cdrfiuba/skil/doc/caratula.tex

{
  
\centering reemplazar esta pagina por la que está armada en LibreOffice

\begin{center}
  \begin{tabular}{p{0.8\linewidth} p{3cm}}
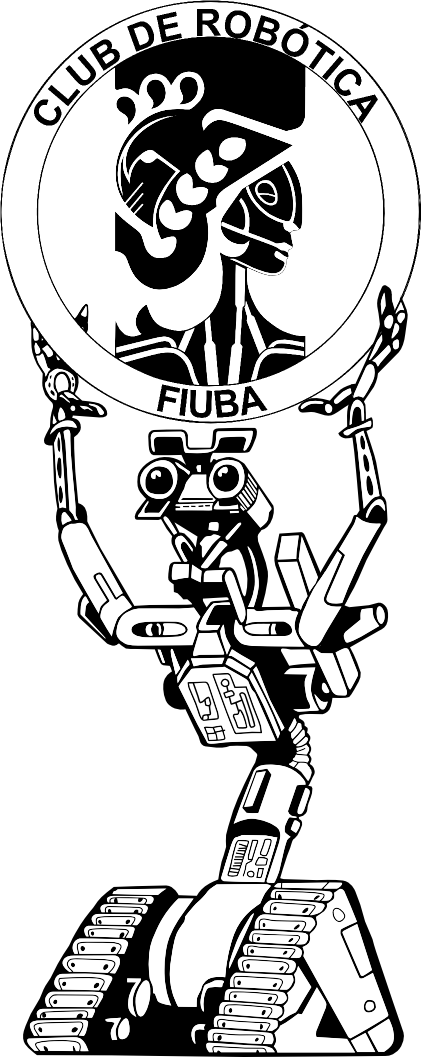
[picture p1: doc/img/logo_johnny5.png]
    \Huge Competencia de Robótica & \multirow{3}{*}{} \\
    {\Huge JOHNNY 5 }& \\
    $\sim$2015$\sim$&
  \end{tabular}
\end{center}
\large

\vspace{2cm}

Categoría: Minisumo

\vspace{.5cm}

Nombre del Robot: {\bfseries Skil}

\vspace{.5cm}

\begin{center}

\end{center}

\vspace{.5cm}

Insitutción: Club de Robótica - FIUBA

\vspace{.5cm}

Participantes:

\vspace{.5cm}

\begin{tabular}{ll}
  $\bullet$ Ariel Burman & arielburman@gmail.com \\
  $\bullet$ Sebastián García Marra&  \\
  $\bullet$ Joaquín de Andrés &
\end{tabular}

}
