cdrfiuba/skil/doc/skil-caratula.odt

Competencia de robótica


JOHNNY 5

~2015~

Categoría: Minisumo

Nombre robot: Skil

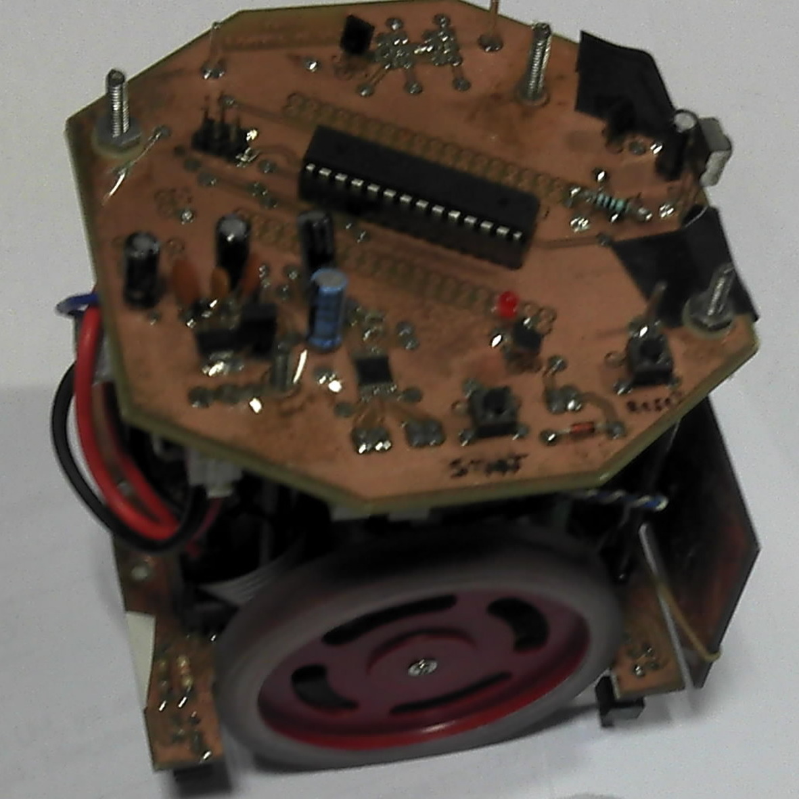
[picture p6: figure]

Institución: Club de Robótica - FIUBA

Participantes:

- Ariel Burman arielburman@gmail.com
- Sebastián García Marra
- Joaquín de Andrés
