cdrfiuba/skil/doc/img/mainboard.pdf

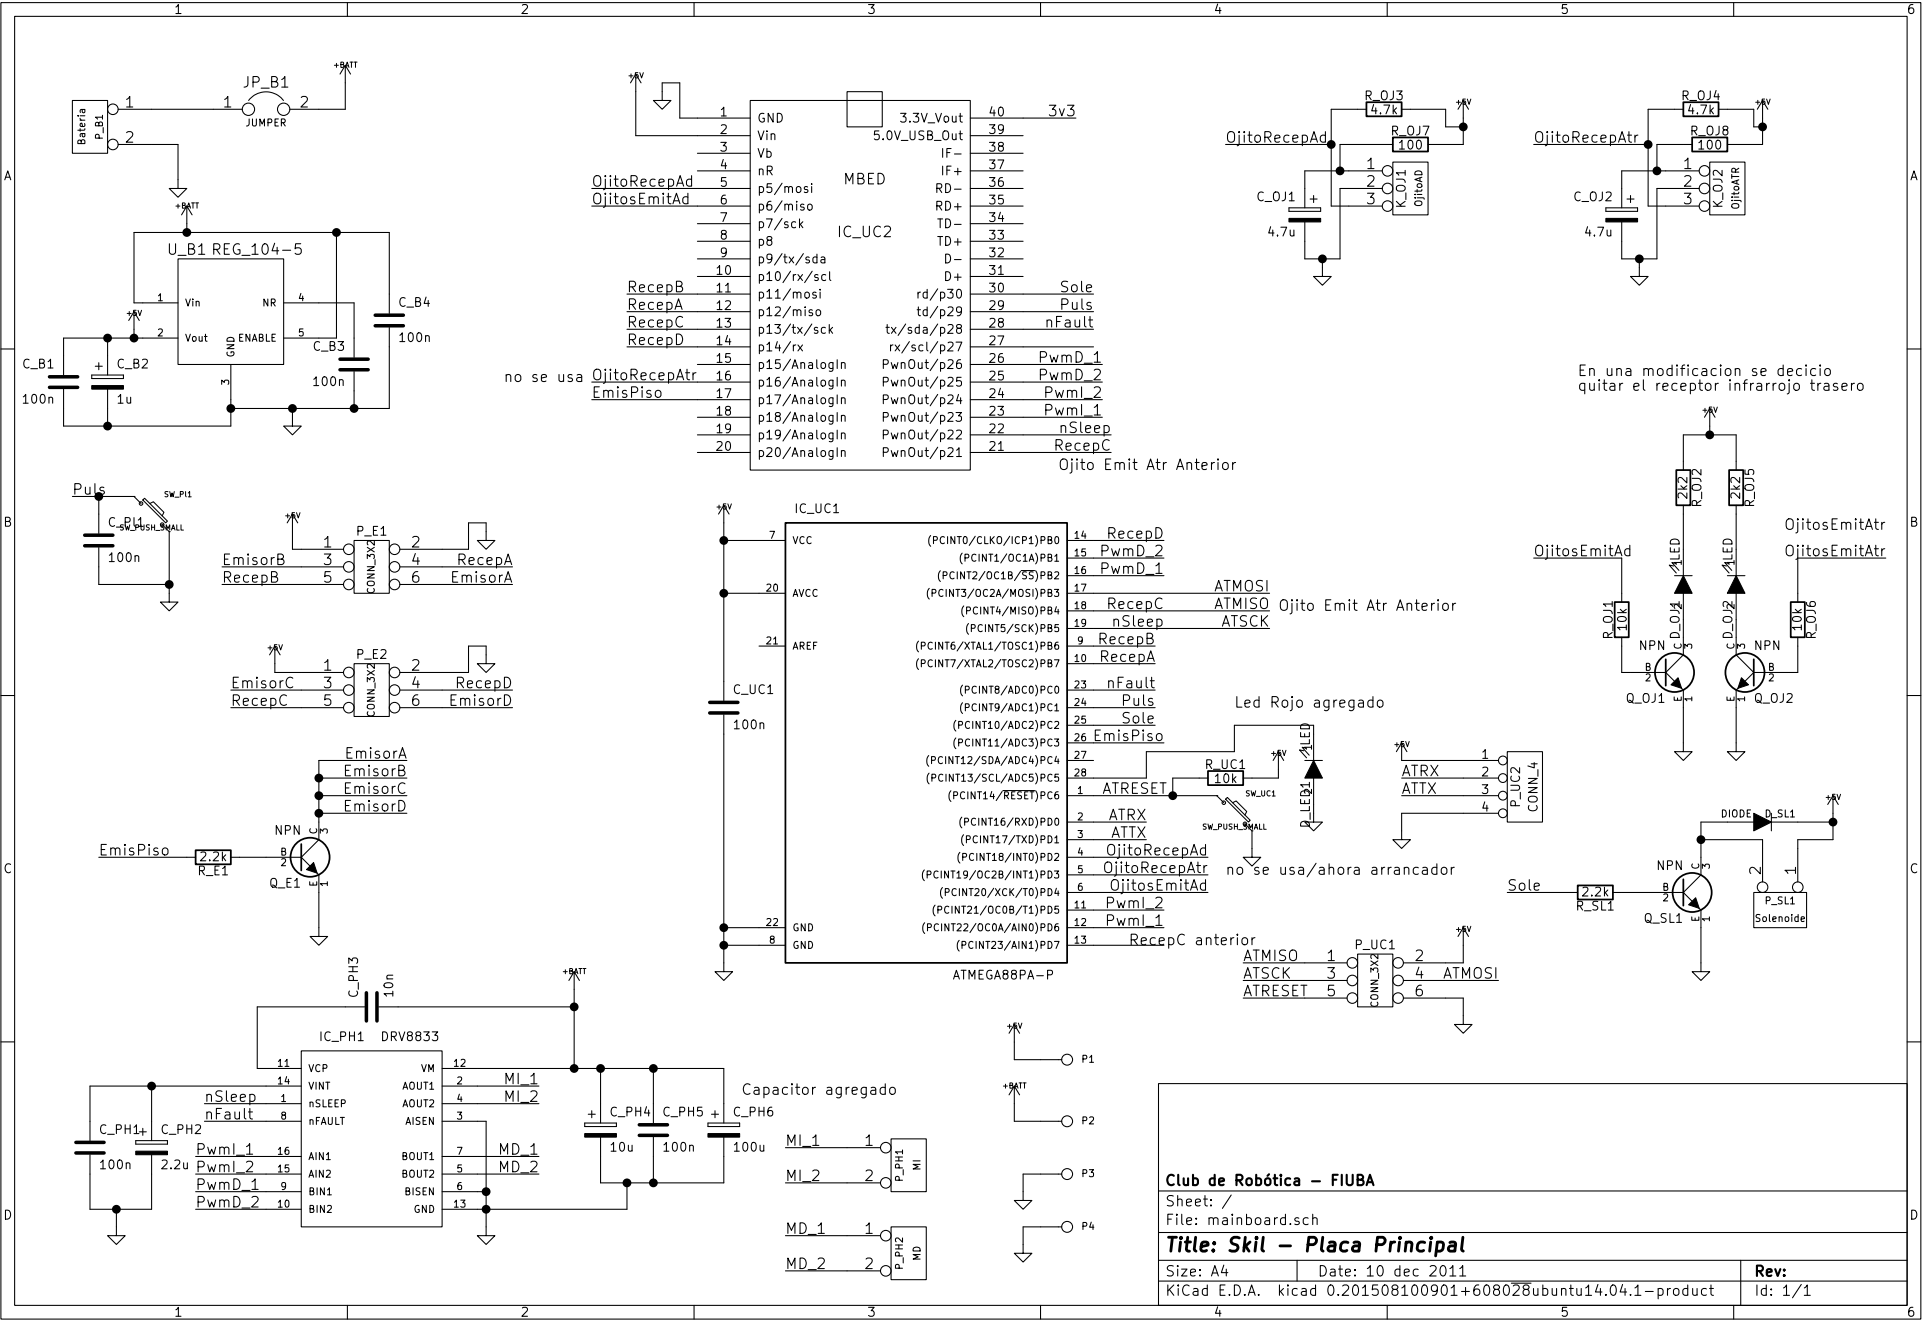
[picture p7: page 1]
D Date: 10 dec 2011 KiCad E.D.A. kicad 0.201508100901+608028ubuntu14.04.1-product Size: A4; Rev:; Capacitor agregado C_PH6; RecepC anterior; En una modificacion se decicio; 1 2 D_LED1 LED; +5VATRX; ATTX; ATRX; P_UC² CONN_4; +BATT; ATMOSI; ATSCK; ATMISO; ATRESET; ATMOSI ⁺⁵V ATMISO; P_UC1 CONN_3X²; OjitosEmitAd; nFault nSleep Puls PwmI_2; PwmI_1; PwmD_2 PwmD_1; OjitoRecepAtr; RecepD; RecepC; RecepB RecepA; SW_UC1 SW_PUSH_SMALL OjitoRecepAtr; OjitoRecepAd; (PCINT14/RESET)PC6; (PCINT16/RXD)PD0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

no se usa

quitar el receptor infrarrojo trasero

RecepC
Ojito Emit Atr Anterior

3 Q_E1 NPN OjitosEmitAd OjitosEmitAtr E
EmisorB

Led Rojo agregado

OjitoRecepAd EmisPiso Sole

no se usa/ahora arrancador

Id: 1/1 Title: Skil - Placa Principal File: mainboard.sch Sheet: / Club de Robótica - FIUBA
