cdrfiuba/skil/doc/img/sensores.pdf

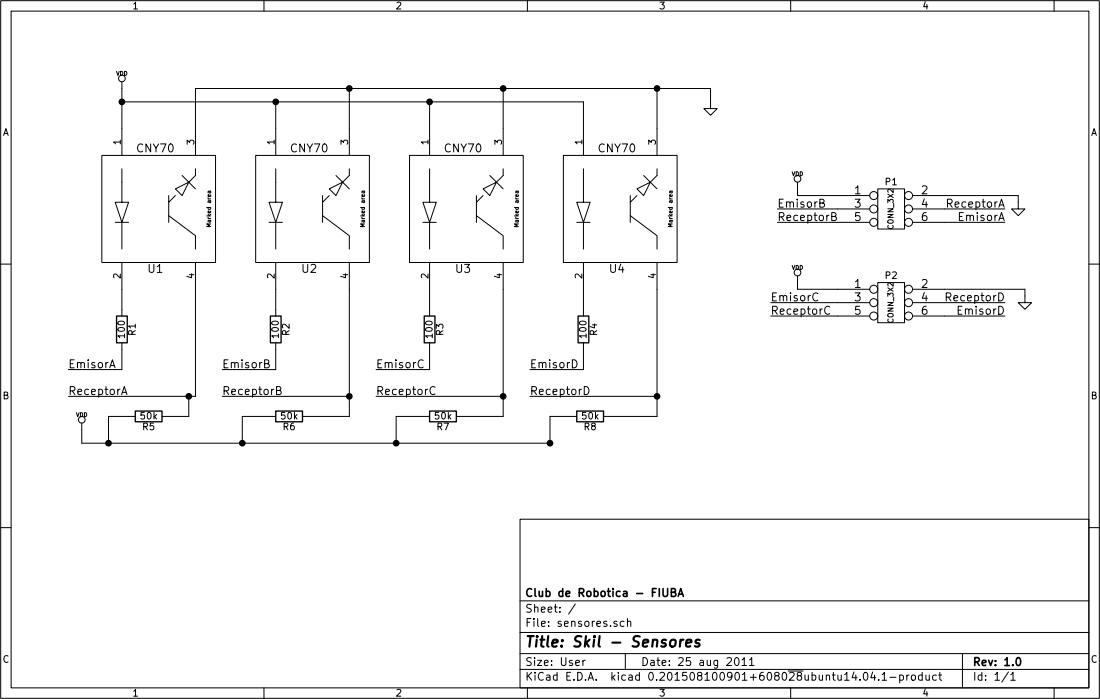
[picture p8: page 1]
B Date: 25 aug 2011; C KiCad E.D.A. kicad 0.201508100901+608028ubuntu14.04.1-product Size: User; Rev: 1.0; 50k VDD ReceptorA ¹⁰⁰ R¹; ReceptorB; EmisorB; ReceptorA; EmisorA ReceptorD; ReceptorC; EmisorD; EmisorC; VDD; P2CONN_3X² 1; P1CONN_3X²; ReceptorD; EmisorA; Marked area 1 2; 3 4U4 CNY70 Marked area 1 2; 3 4U3 CNY70 Marked area 1 2; 3 4U2 CNY70 Marked area 1 2; 3 4U1 CNY70

File: sensores.sch Sheet: / Club de Robotica - FIUBA

Id: 1/1 Title: Skil - Sensores
