cdrfiuba/skil/placas/mainboard/mainboard.sch

## KiCad design placas/mainboard/mainboard.sch (2015-08-15, an earlier design)

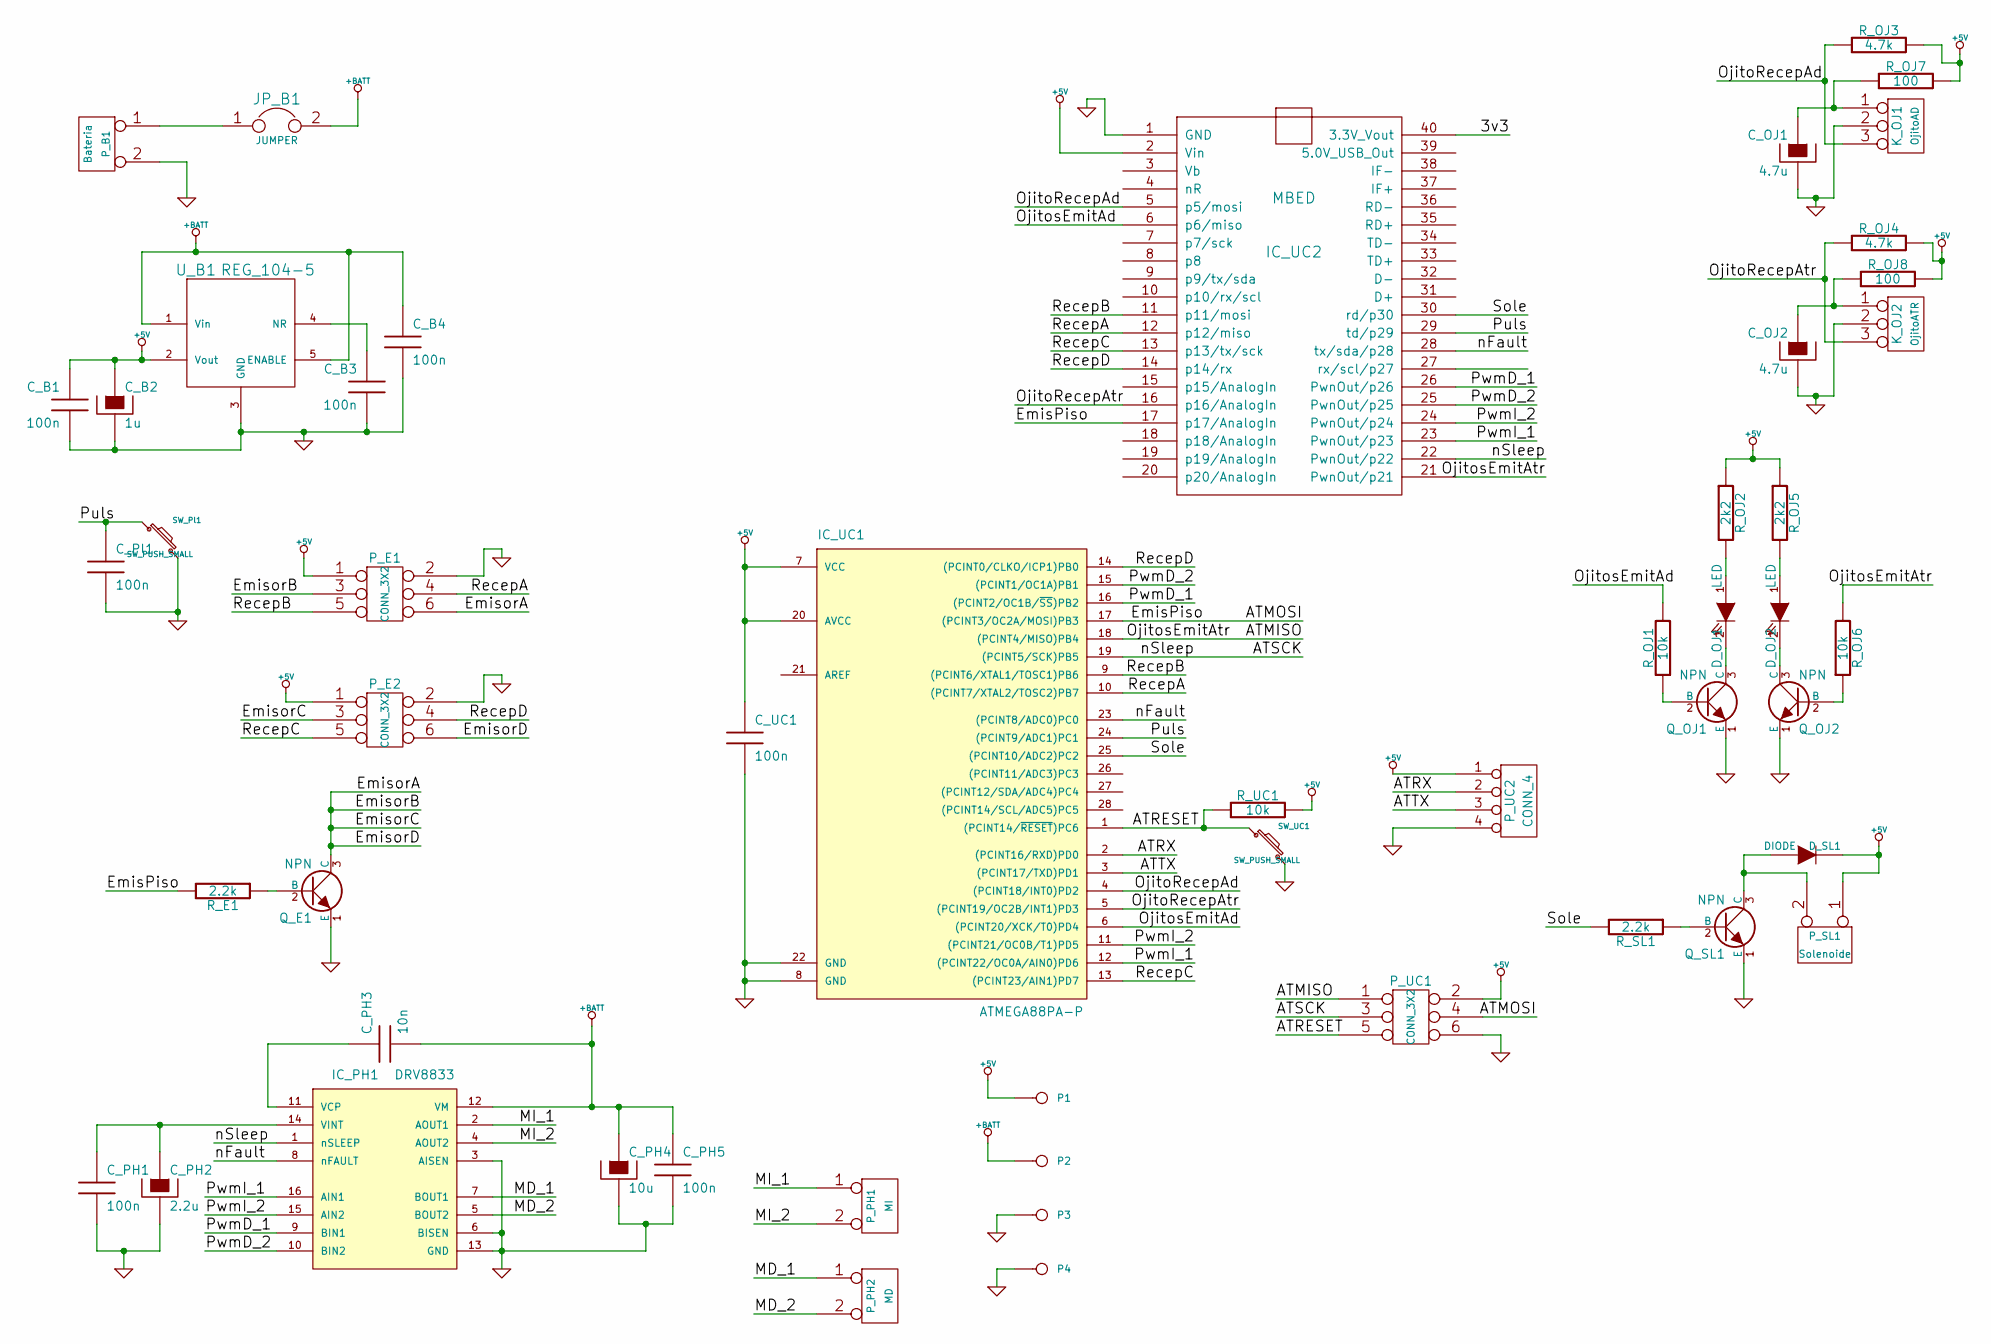
[picture p9: schematic mainboard.sch]

Parts:
C_B1, C_B3, C_B4: 100n
C_B2: 1u
C_OJ1, C_OJ2: 4.7u
C_PH1, C_PH5: 100n
C_PH2: 2.2u
C_PH3: 10n
C_PH4: 10u
C_Pl1: 100n
C_UC1: 100n
D_OJ1, D_OJ2: LED
D_SL1: DIODE
IC_PH1: DRV8833
IC_UC1: ATMEGA88PA-P; DIL28
IC_UC2: MBED
JP_B1: JUMPER
K_OJ1: OjitoAD
K_OJ2: OjitoATR
P1, P2, P3, P4: CONN_1
P_B1: Bateria
P_E1, P_E2: CONN_3X2
P_PH1: MI
P_PH2: MD
P_SL1: Solenoide
P_UC1: CONN_3X2
P_UC2: CONN_4
Q_E1: NPN
Q_OJ1, Q_OJ2: NPN
Q_SL1: NPN
R_E1: 2.2k
R_OJ1, R_OJ6: 10k
R_OJ2, R_OJ5: 2k2
R_OJ3, R_OJ4: 4.7k
R_OJ7, R_OJ8: 100
R_SL1: 2.2k
R_UC1: 10k
SW_Pl1: SW_PUSH_SMALL
SW_UC1: SW_PUSH_SMALL
U_B1: REG_104-5

Connections:
3v3: IC_UC2.40 (3.3V_Vout)
+5V: C_B1.1, C_B2.1, C_UC1.1, D_SL1.2 (K), IC_UC1.7 (VCC), IC_UC1.20 (AVCC), IC_UC2.2 (Vin), P1.1, P_E1.1, P_E2.1, P_SL1.1, P_UC1.2, P_UC2.1, R_OJ2.1, R_OJ3.2, R_OJ4.2, R_OJ5.1, R_OJ7.2, R_OJ8.2, R_UC1.2, U_B1.2 (Vout)
+BATT: C_B4.1, C_PH3.2, C_PH4.1, C_PH5.1, IC_PH1.12 (VM), JP_B1.2, P2.1, U_B1.1 (Vin), U_B1.5 (ENABLE)
ATMISO: IC_UC1.18 ((PCINT4/MISO)PB4), IC_UC2.21 (PwnOut/p21), P_UC1.1, R_OJ6.2
ATMOSI: IC_UC1.17 ((PCINT3/OC2A/MOSI)PB3), IC_UC2.17 (p17/AnalogIn), P_UC1.4, R_E1.2
ATRESET: IC_UC1.1 ((PCINT14/~RESET~)PC6), P_UC1.5, R_UC1.1, SW_UC1.1
ATRX: IC_UC1.2 ((PCINT16/RXD)PD0), P_UC2.2
ATSCK: IC_PH1.1 (nSLEEP), IC_UC1.19 ((PCINT5/SCK)PB5), IC_UC2.22 (PwnOut/p22), P_UC1.3
ATTX: IC_UC1.3 ((PCINT17/TXD)PD1), P_UC2.3
EmisorA: P_E1.3, P_E1.6, P_E2.3, P_E2.6, Q_E1.3 (C)
GND: C_B1.2, C_B2.2, C_B3.2, C_B4.2, C_OJ1.2, C_OJ2.2, C_PH1.2, C_PH2.2, C_PH4.2, C_PH5.2, C_Pl1.2, C_UC1.2, IC_PH1.3 (AISEN), IC_PH1.6 (BISEN), IC_PH1.13 (GND), IC_UC1.8 (GND), IC_UC1.22 (GND), IC_UC2.1 (GND), K_OJ1.2 (PM), K_OJ2.2 (PM), P3.1, P4.1, P_B1.2 (PM), P_E1.2, P_E2.2, P_UC1.6, P_UC2.4, Q_E1.1 (E), Q_OJ1.1 (E), Q_OJ2.1 (E), Q_SL1.1 (E), SW_Pl1.2, SW_UC1.2, U_B1.3 (GND)
MD_1: IC_PH1.7 (BOUT1), P_PH2.1
MD_2: IC_PH1.5 (BOUT2), P_PH2.2 (PM)
MI_1: IC_PH1.2 (AOUT1), P_PH1.1
MI_2: IC_PH1.4 (AOUT2), P_PH1.2 (PM)
unnamed: C_B3.1, U_B1.4 (NR)
unnamed: C_OJ1.1, K_OJ1.1, R_OJ7.1
unnamed: C_OJ2.1, K_OJ2.1, R_OJ8.1
unnamed: C_PH1.1, C_PH2.1, IC_PH1.14 (VINT)
unnamed: C_PH3.1, IC_PH1.11 (VCP)
unnamed: D_OJ1.1 (A), R_OJ2.2
unnamed: D_OJ1.2 (K), Q_OJ1.3 (C)
unnamed: D_OJ2.1 (A), R_OJ5.2
unnamed: D_OJ2.2 (K), Q_OJ2.3 (C)
unnamed: D_SL1.1 (A), P_SL1.2 (PM), Q_SL1.3 (C)
unnamed: JP_B1.1, P_B1.1
unnamed: Q_E1.2 (B), R_E1.1
unnamed: Q_OJ1.2 (B), R_OJ1.1
unnamed: Q_OJ2.2 (B), R_OJ6.1
unnamed: Q_SL1.2 (B), R_SL1.1
OjitoRecepAd: IC_UC1.4 ((PCINT18/INT0)PD2), IC_UC2.5 (p5/mosi), K_OJ1.3, R_OJ3.1
OjitoRecepAtr: IC_UC1.5 ((PCINT19/OC2B/INT1)PD3), IC_UC2.16 (p16/AnalogIn), K_OJ2.3, R_OJ4.1
OjitosEmitAd: IC_UC1.6 ((PCINT20/XCK/T0)PD4), IC_UC2.6 (p6/miso), R_OJ1.2
Puls: C_Pl1.1, IC_UC1.24 ((PCINT9/ADC1)PC1), IC_UC2.29 (td/p29), SW_Pl1.1
PwmD_1: IC_PH1.9 (BIN1), IC_UC1.16 ((PCINT2/OC1B/~SS~)PB2), IC_UC2.26 (PwnOut/p26)
PwmD_2: IC_PH1.10 (BIN2), IC_UC1.15 ((PCINT1/OC1A)PB1), IC_UC2.25 (PwnOut/p25)
PwmI_1: IC_PH1.16 (AIN1), IC_UC1.12 ((PCINT22/OC0A/AIN0)PD6), IC_UC2.23 (PwnOut/p23)
PwmI_2: IC_PH1.15 (AIN2), IC_UC1.11 ((PCINT21/OC0B/T1)PD5), IC_UC2.24 (PwnOut/p24)
RecepA: IC_UC1.10 ((PCINT7/XTAL2/TOSC2)PB7), IC_UC2.12 (p12/miso), P_E1.4
RecepB: IC_UC1.9 ((PCINT6/XTAL1/TOSC1)PB6), IC_UC2.11 (p11/mosi), P_E1.5
RecepC: IC_UC1.13 ((PCINT23/AIN1)PD7), IC_UC2.13 (p13/tx/sck), P_E2.5
RecepD: IC_UC1.14 ((PCINT0/CLKO/ICP1)PB0), IC_UC2.14 (p14/rx), P_E2.4
Sole: IC_UC1.25 ((PCINT10/ADC2)PC2), IC_UC2.30 (rd/p30), R_SL1.2
nFault: IC_PH1.8 (nFAULT), IC_UC1.23 ((PCINT8/ADC0)PC0), IC_UC2.28 (tx/sda/p28)
