cdrfiuba/skil/placas/sensores/sensores.sch

## KiCad design placas/sensores/sensores.sch (2015-08-15, an earlier design)

Schematic: sensores.sch

Parts:
P1, P2: CONN_3X2
R1, R2, R3, R4: 100
R5, R6, R7, R8: 50k
U1, U2, U3, U4: CNY70
