cdrfiuba/skil/src/atmega88/skil.c

#include <avr/io.h>
#include <avr/interrupt.h>
#include <util/delay.h>

#include "motores.h"
#include "sensores.h"
#include "skil.h"

#define DELAY_ESTADO    2 // en milisegundos
#define DELAY_ESCAPE    500 // en milisegundos
#define DELAY_INICIO    200 // en milisegundos 5100
#define ALEATOREO_DELAY   500

// la macro 
#define proximoEstadoAleatorio() (TCNT2 & 0x03) //Devuelve un numero aleatorio entre 0 y 3
#define ALEATOREO_MAX_CUENTA   5000 

volatile estados_t estado;

// utilizado para definir la cantidad de repeticion de la misma accion aleatorio
// (ver accionTracking )
volatile uint8_t cantVeces;

int main (void) {
	setup();

//	if (IsPulsadorSet() == false) { 
//
//    desenergizarSolenoide();
//    EncenderMotores();
//    cli();
//    while(1) movimientoPrueba();
//  }
  _delay_ms(100);
  while(estado==DETENIDO);
  Led1On();
  // Necesario para el encendido remoto
  //while ((PIN_REMOTO & (1<<REMOTO_NUMBER)) == 0);
  Led1Off();

  //tiempo de espera para bajar pollera y o sin encendido remoto
  _delay_ms(DELAY_INICIO);

  // la pollera no la estamos usando, pero mejor desconectarla
  // el solenoide no puede que
  desenergizarSolenoide();
  
  encenderEmisorSuperior();
  encenderEmisorInferior();
  _delay_ms(5);

	while(1){

    // Verifica el puente H
    if (IsnFaultSet()==0) {
      titilarLed(20);
      ConfigurarMotores();
      EncenderMotores();
      MoverAdelante();
    }
    // apagado remoto
    //if ((PIN_REMOTO & (1<<REMOTO_NUMBER)) == 0) ApagarMotores();
    sensoresInf = PINB & MASK_INT_PIN_ALL;


    switch (sensoresInf){
      case OK:
        switch(estado){
          case FIGHT_ADELANTE:
            Led1On();
	          MoverAdelante();
            break;
          case TRACKING:
            Led1Off();
            accionTracking();
            break;
          case ESCAPE:
            Led1Off();
            break;
          case DETENIDO:
          default: 
            ApagarMotores();
            titilarLed(12);
            break;
        }
        break;
      case ATRAS:
        estado = ESCAPE;
        arrancarTimerEstados(0x6000);
        MoverAdelante();
        break;
      case ADELANTE:
        estado = ESCAPE;
        arrancarTimerEstados(0x9000);
        MoverAtras();
        break;
      case ADELANTE_DER:
        estado = ESCAPE;
        arrancarTimerEstados(0x6000);
        GirarIzquierdaAtras();
        break;
      case ADELANTE_IZQ:
        estado = ESCAPE;
        arrancarTimerEstados(0x6000);
        GirarDerechaAtras();
        break;
      case ATRAS_DER:
        estado = ESCAPE;
        arrancarTimerEstados(0x1000);
        GirarIzquierdaAdelante();
        break;
      case ATRAS_IZQ:
        estado = ESCAPE;
        arrancarTimerEstados(0x1000);
        GirarDerechaAdelante();
        break;
      case DERECHA:
        estado = ESCAPE;
        arrancarTimerEstados(0x1000);
        GirarIzquierdaAdelante();
        //RotarIzquierda();
        break;
      case IZQUIERDA:
        estado = ESCAPE;
        arrancarTimerEstados(0x1000);
        //RotarDerecha();
        GirarDerechaAdelante();
        break;
      default:
        //ApagarMotores();
        //titilarLed(10);
        break;
    }
  }
}


void setup (void) {
	ConfigurarMotores();
	configurarPinSensoresSup();
	configurarPinSensoresInf();
	configurarTimerSensoresSup();
	configurarTimerEstados();
	configurarPulsador();
	configurarRemoto();
  configurarSolenoide();
//  energizarSolenoide();
  Led1Init();
  Led1Off();

	estado = DETENIDO;
  cantVeces = 0;
	sei();
}

void configurarPulsador(void){
	PulsadorInit();
	// Configuro el pin change
	PCICR |= (1<<PCIE1);
	PCMSK1 = (1<<PCINT9);
}

void configurarRemoto(void){
  ClearBit(DDR_REMOTO, REMOTO_NUMBER);
  SetBit(PORT_REMOTO, REMOTO_NUMBER);
}

void accionTracking(void){
	uint8_t temp;
  if (cantVeces < ALEATOREO_MAX_CUENTA) {
    cantVeces++;
  }
  else{
    cantVeces=0;
    temp = proximoEstadoAleatorio();
    switch(temp) {
      case 0:
        RotarIzquierda();
        break;
      case 1:
        GirarDerechaAdelante();
        break;
      case 2:
        GirarDerechaAtras();
        break;
      case 3:
        RotarDerecha();
        break;
    }
  }
}

// Interrupcion de pulsador (vetor_4)
ISR(PCINT1_vect) {
	// Delay para debounce
	// Dado que no tenemos necesidad de hacer nada mientras esperamos por el
	// debounce lo dejamos asi. Sino, deberiamos utilizar algun timer
	_delay_ms(250);

	if (IsPulsadorSet() == true) { 
	// significa que esta en 1 y hubo flanco ascendente genuino
	// se podria reemplazar la variable por poner apagar todo, poner 
	// el micro a dormir esperando solo esta interrupcion y luego
	// despertalo. Aca se lo despertaria
    EncenderMotores();
  
    //estado = TRACKING;
    estado = FIGHT_ADELANTE;
	}

  // Este flag se clerea a mano porque el clear por hardware se realiza en el
  // momento que se atiende la interrupcion y no cuando se sale de ella.
  // Esto hace que mientras se esta dentro de la interrupcion, puedan generarse
  // nueos flancos (ruido) que no queremos atender
  SetBit(EIFR, INTF0);
}


/* funciones de prueba */
void movimientoPrueba(void){
	MoverAdelante();
	_delay_ms(400);
	GirarIzquierdaAtras();
	_delay_ms(400);
	GirarDerechaAtras();
	_delay_ms(400);
	MoverAtras();
	_delay_ms(100);
}

void titilarLed(uint8_t numero){
  uint8_t i;
  
  Led1Off();
  for (i=0;i<(2*numero);i++){
    Led1Toggle();
    _delay_ms(200);
  }
    _delay_ms(300);
}
