cdrfiuba/skil/(commit log)

2011-08-25 inicio el repo
    [mainboard.brd, mainboard.sch, sensores.brd, sensores.sch]
2011-08-26 placa principal terminada
    [mainboard.brd, mainboard.sch]
2011-08-26 retoques finales
    [mainboard.brd, mainboard.sch]
2011-08-26 Acomode la placa de los sensores y le agregue agujeros para las bolitas y dos tornillos mas
    [sensores.brd, sensores.sch]
2011-09-26 codigo de la cuenta de seba del 25-9
2011-10-14 cambios en el puente h, reubicacion de componentes en la placa
    [mainboard.brd, mainboard.sch]
2011-11-03 nueva version de la placa mainboard
    [mainboard.brd, mainboard.sch]
2011-11-03 nueva version de la placa mainboard actual
    [mainboard.brd]
2011-11-04 primer intento de codigo de atmega
    [mainboard.brd]
2011-11-07 Agrego archivos de la placa de la pollera
    [pollera.brd]
2011-11-07 agrego cache de bibliotecas de kicad
2011-11-07 Arregle la definicion de los puertos de los sensores superiores
    [sensores.h]
2011-11-07 Agrego codigo de sensores superiores y arreglos de errores anteriores
    [sensores.c, sensores.h, skil.c]
2011-11-07 correcciones de los motores
2011-11-08 Agrego el script para calcular OCR del timer2
2011-11-08 Estamos agregando codigo para los sensores, todavia no hay nada probado ni terminado
2011-11-08 agrego sensores al makefile
2011-11-09 Varios cambios. No tengo ni idea que son.
2011-11-11 agregado de solenoide y sensor atras superior
2011-11-11 algunos arreglos de codigo y prueba de sensores. Los sensores andan todos, pero los de abajo no se comportan bien.
    [motores.h, skil.c]
2011-11-11 arreglamos boton de arranque
    [skil.c]
2011-11-11 cambiamos el encendido de todos los emisores
2011-11-11 cambios en las mascaras de los sensores
2011-11-11 ultimos cambios en la compu de seba
2011-11-12 Arreglos de todo el codigo, andan bien sensores de abajo
    [sensores.c, sensores.h, skil.c]
2011-11-12 ultimos retoques de la noche
2011-11-17 update a la anteultima version de bahia 2011
    [mainboard.brd, mainboard.sch, pollera.brd, sensores.brd, sensores.sch]
2011-11-26 corregimos los detalles que faltaban de bahia, agregamos un led y un codigo para contemplar el fault
2011-12-10 reposicionamos un receptor del piso y eliminamos el receptor infrarrojo trasero
    [mainboard.sch]
2011-12-10 remapeo de un sensor inferior para tener todos en el mismo puerto. y algunas pruebas mas.
2011-12-10 cambios previos que habia echo junto con el esquematico
2011-12-11 * Limpie el codigo de comentarios y funciones que no se usaban. Todavia quedan algunas cosas por ver * Movi las interrupciones de los sensores, de skil.c a sensores.c, ademas cambie la ubicacion de l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
2011-12-11 Puse el micro que usamos para no tener que forzar con -F Buscar en la pagina de redmine, en el wiki del programador como agregar el micro que falta
2011-12-11 Cambios en el programa principal Volvi a poner la funcion de aleatoriedad. Hay que testear el funcionamiento y los tiempos.
2012-05-06 modificamos la forma en que usamos los sensores inferiores. ya no estan por interrupcion sino que se leen todo el tiempo, al comienzo del loop principal. Habria que mejorar la estructura del programa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
    [motores.c, motores.h, sensores.c, sensores.h, skil.c, skil.h]
2013-05-03 version antes de modificar el nuevo esquema preparado con tom
2015-08-15 se agrego codigo para el circuito de arranque remoto
2015-08-15 actualizo las placas con las modificaciones hechas
    [mainboard.sch, sensores.sch]
2015-08-15 primera documentacion de skil en 4 anios
2024-07-27 cambios para iniciar robot sin control remoto
2024-07-27 wip en pcbs
    [adaptador.sch]
